FullStackEmbedded/WeatherShield/03_ExternalDocumentation/datasheet/rj11.jpeg

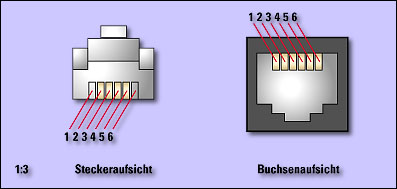
03_ExternalDocumentation/datasheet/rj11.jpeg
