FullStackEmbedded/WeatherShield/(threads)

Thread 5 (2015-12-03):

Update database

erget, 2015-12-03:
transfer data regularly to the database to make it accessible to the web server

This involves reading the sensor readings in ``/dev`` and generating SQL to interact with Django's SQLite database

erget, 2015-12-09:
@NicolasCaspari - pressureless assignment ;)

erget, 2015-12-09:
1. Script that can interact with Django layer for saving observations in database
1. Have script read sensor observations (located in ``/dev``) and save them in ``Observation`` objects that go into the DB
1. Cronjob that keeps this happening every hour (or other test period that you choose)
