FullStackEmbedded/WeatherShield/01_EagleDocuments/Base_Shield/WeatherShield_Base.brd

## EAGLE design 01_EagleDocuments/Base_Shield/WeatherShield_Base.brd (2015-11-12)

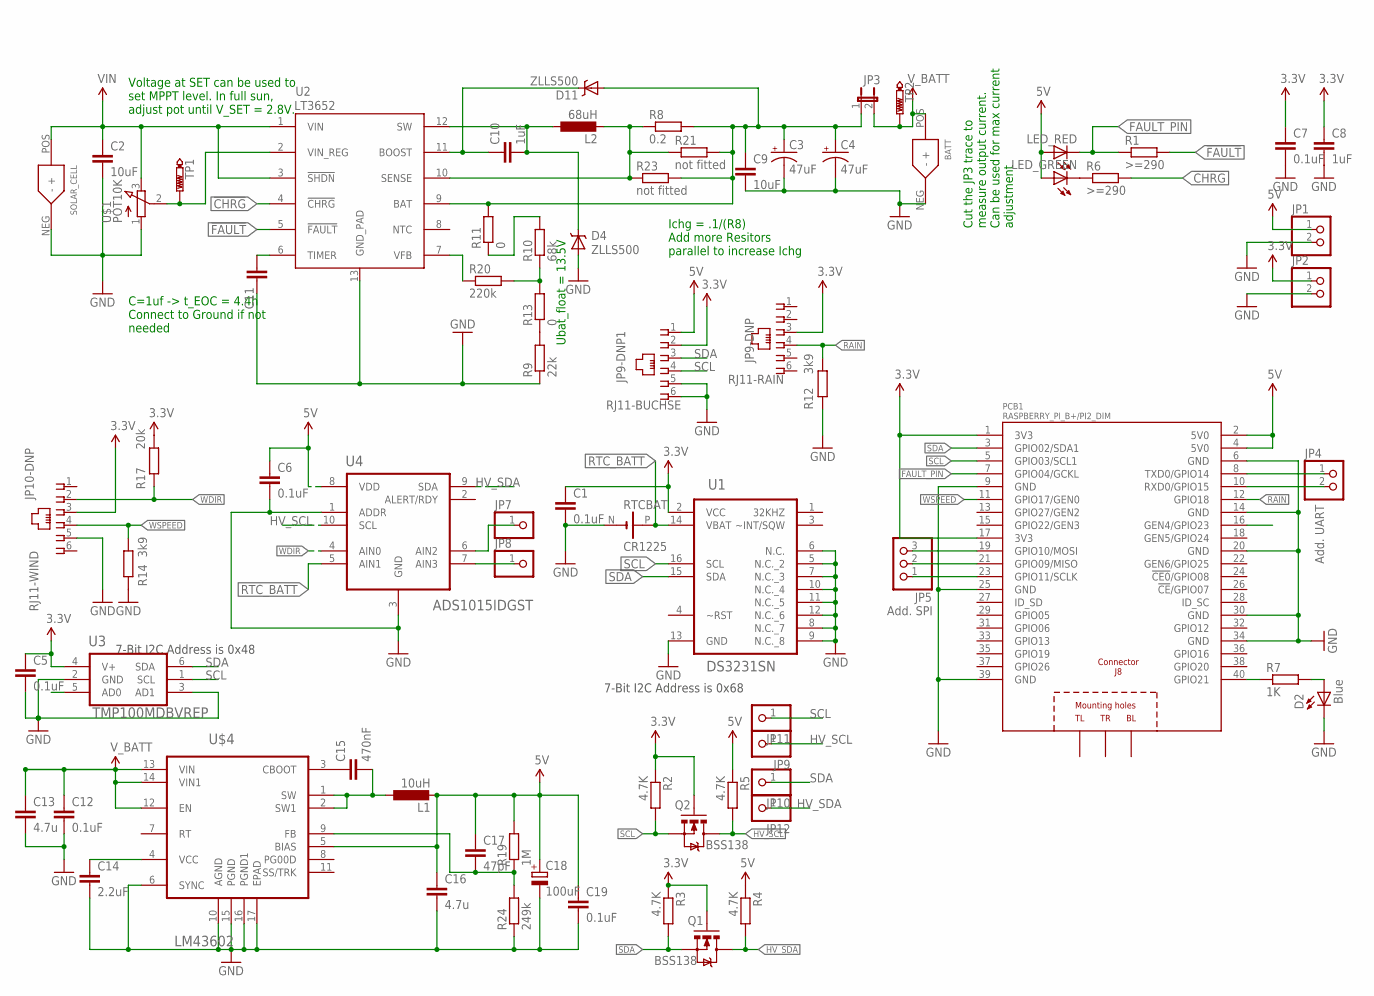
[picture p2: schematic WeatherShield_Base.sch]

Parts:
BATT: XT-60
C1, C5, C6, C7: 0.1uF; C0603
C2, C9: 10uF; C0603
C3, C4: 47uF; EIA7343-20
C8, C10: 1uF; C0603
C11: 1.0uF; C0603
C12, C19: 0.1uF; C1206
C13: 4.7u; C1206
C14: 2.2uF; C0603
C15: 470nF; C0603
C16: 4.7u; C0603
C17: 47pF; C0603
C18: 100uF; E2,5-6E
D2: Blue; LED-0603
D4, D11: ZLLS500; SOT23
JP1, JP2, JP4: PINHD-1X2; 1X02
JP3: JUMPER-PTH-2-NC; PTH-JUMPER-NC_BOTTOM_NO_SILK
JP5: PINHD-1X3; 1X03
JP7, JP8, JP9, JP10, JP11, JP12: PINHD-1X1; 1X01
JP9-DNP: RJ11-RAIN; RJ11-STECKER
JP9-DNP1: RJ11-BUCHSE; RJ11-STECKER
JP10-DNP: RJ11-WIND; RJ11-STECKER
L1: 10uH; 6000-XXXX-RC
L2: 68uH; 6000-XXXX-RC
LED_GREEN: LEDSML0603; SML0603
LED_RED: LEDSML0603; SML0603
PCB1: RASPBERRY_PI_B+/PI2_DIM; RASPBERRY_PI_BPLUS_DIM
Q1, Q2: BSS138; SOT23-3
R1, R6: >=290; R0603
R2, R3, R4, R5: 4.7K; R0603
R7: 1K; R0603
R8: 0.2; R0805
R9: 22k; R0603
R10: 68k; R0603
R11, R13: 0; R0603
R12, R14: 3k9; R0603
R17: 20k; R0603
R19: 1M; R0805
R20: 220k; R0603
R21, R23: not fitted; R0805
R24: 249k; R0805
RTCBAT: CR1225; BATTERIE_HALTER_CR1225
SOLAR_CELL: XT-60
TP1, TP2: SET; B1,27
U1: DS3231SN; SOIC127P1032X265-16N
U2: LT3652; MSOP-12_GND
U3: TMP100MDBVREP; SOT95P280X145-6N
U4: ADS1015IDGST; SOP50P490X110-10N
U$1: POT10K; POT_TS63Y_10K
U$4: LM43602; HTSSOP-16

Connections:
3.3V: C1.1, C5.1, C7.1, C8.1, JP2.1, JP9-DNP.3, JP9-DNP1.2, JP10-DNP.3, PCB1.1 (3V3), PCB1.17 (3V3), Q1.1 (G), Q2.1 (G), R2.1, R3.1, R17.1, U1.2 (VCC), U3.4 (V+)
5V: C6.1, C16.1, C17.1, C18.+, C19.1, JP1.1, JP9-DNP1.1, L1.2, LED_GREEN.A, LED_RED.A, PCB1.2 (5V0), PCB1.4 (5V0), R4.1, R5.1, R19.2, U4.8 (VDD), U$4.5 (BIAS)
!CHRG: R6.2, U2.4 (!CHRG)
!FAULT: R1.2, U2.5 (!FAULT)
BOOST: C10.1, D11.3 (C), U2.11 (BOOST)
FAULT_PIN: LED_RED.C, PCB1.7 (GPIO04/GCKL), R1.1
FB: R10.1, R13.2, R20.2
GND: BATT.NEG (-), C1.2, C2.2, C3.C (-), C4.C (-), C5.2, C6.2, C7.2, C8.2, C9.2, C11.1, C12.2, C13.2, C14.2, C16.2, C18.-, C19.2, D2.C, D4.1 (A), JP1.2, JP2.2, JP9-DNP1.5, JP9-DNP1.6, JP10-DNP.5, PCB1.6 (GND), PCB1.9 (GND), PCB1.14 (GND), PCB1.20 (GND), PCB1.25 (GND), PCB1.30 (GND), PCB1.34 (GND), PCB1.39 (GND), R9.1, R12.2, R14.2, R24.1, RTCBAT.N (-), SOLAR_CELL.NEG (-), U1.5 (N.C._2), U1.6 (N.C.), U1.7 (N.C._3), U1.8 (N.C._7), U1.9 (N.C._8), U1.10 (N.C._4), U1.11 (N.C._5), U1.12 (N.C._6), U1.13 (GND), U2.13 (GND_PAD), U3.2 (GND), U3.3 (AD1), U4.1 (ADDR), U4.3 (GND), U$1.1 (A), U$4.6 (SYNC), U$4.10 (AGND), U$4.15 (PGND), U$4.16 (PGND1), U$4.17 (EPAD)
HV_SCL: JP9.1, Q2.3 (D), R5.2, U4.10 (SCL)
HV_SDA: JP12.1, Q1.3 (D), R4.2, U4.9 (SDA)
unnamed: R9.2, R13.1
unnamed: R10.2, R11.1
unnamed: LED_GREEN.C, R6.1
unnamed: JP7.1, U4.6 (AIN2)
unnamed: JP8.1, U4.7 (AIN3)
unnamed: D2.A, R7.2
unnamed: R20.1, U2.7 (VFB)
unnamed: C3.A (+), C4.A (+), C9.1, D11.1 (A), JP3.1, R8.2, R11.2, R21.2, R23.2, U2.9 (BAT)
unnamed: C15.1, U$4.3 (CBOOT)
unnamed: JP4.1, PCB1.8 (TXD0/GPIO14)
unnamed: JP4.2, PCB1.10 (RXD0/GPIO15)
unnamed: JP5.3, PCB1.19 (GPIO10/MOSI)
unnamed: JP5.2, PCB1.21 (GPIO09/MISO)
unnamed: C17.2, R19.1, R24.2, U$4.9 (FB)
unnamed: C14.1, U$4.4 (VCC)
unnamed: C15.2, L1.1, U$4.1 (SW), U$4.2 (SW1)
unnamed: JP5.1, PCB1.23 (GPIO11/SCLK)
RAIN: JP9-DNP.4, PCB1.12 (GPIO18), R12.1
RTC_BATT: RTCBAT.P (+), U1.14 (VBAT), U4.5 (AIN1)
SCL: JP9-DNP1.4, JP11.1, PCB1.5 (GPIO03/SCL1), Q2.2 (S), R2.2, U1.16 (SCL), U3.1 (SCL)
SDA: JP9-DNP1.3, JP10.1, PCB1.3 (GPIO02/SDA1), Q1.2 (S), R3.2, U1.15 (SDA), U3.6 (SDA)
SENSE: L2.2, R8.1, R21.1, R23.1, U2.10 (SENSE)
SET: TP1.TP, U2.2 (VIN_REG), U$1.2 (S)
STAT3: PCB1.40 (GPIO21), R7.1
SW: C10.2, D4.3 (C), L2.1, U2.12 (SW)
TIMER: C11.2, U2.6 (TIMER)
VIN: C2.1, SOLAR_CELL.POS (+), U2.1 (VIN), U2.3 (!SHDN), U$1.3 (E)
V_BATT: BATT.POS (+), C12.1, C13.1, JP3.2, TP2.TP, U$4.12 (EN), U$4.13 (VIN), U$4.14 (VIN1)
WDIR: JP10-DNP.2, R17.2, U4.4 (AIN0)
WSPEED: JP10-DNP.4, PCB1.11 (GPIO17/GEN0), R14.1

Notes on the sheet:
Cut the JP3 trace to measure output current. Can be used for max current adjustment
Ichg = .1/(R8) Add more Resitors parallel to increase Ichg
Voltage at SET can be used to set MPPT level. In full sun, adjust pot until V_SET = 2.8V.
C=1uf -> t_EOC = 4.4h Connect to Ground if not needed
Add. UART
Add. SPI
7-Bit I2C Address is 0x68
7-Bit I2C Address is 0x48
Ubat_float = 13.5V

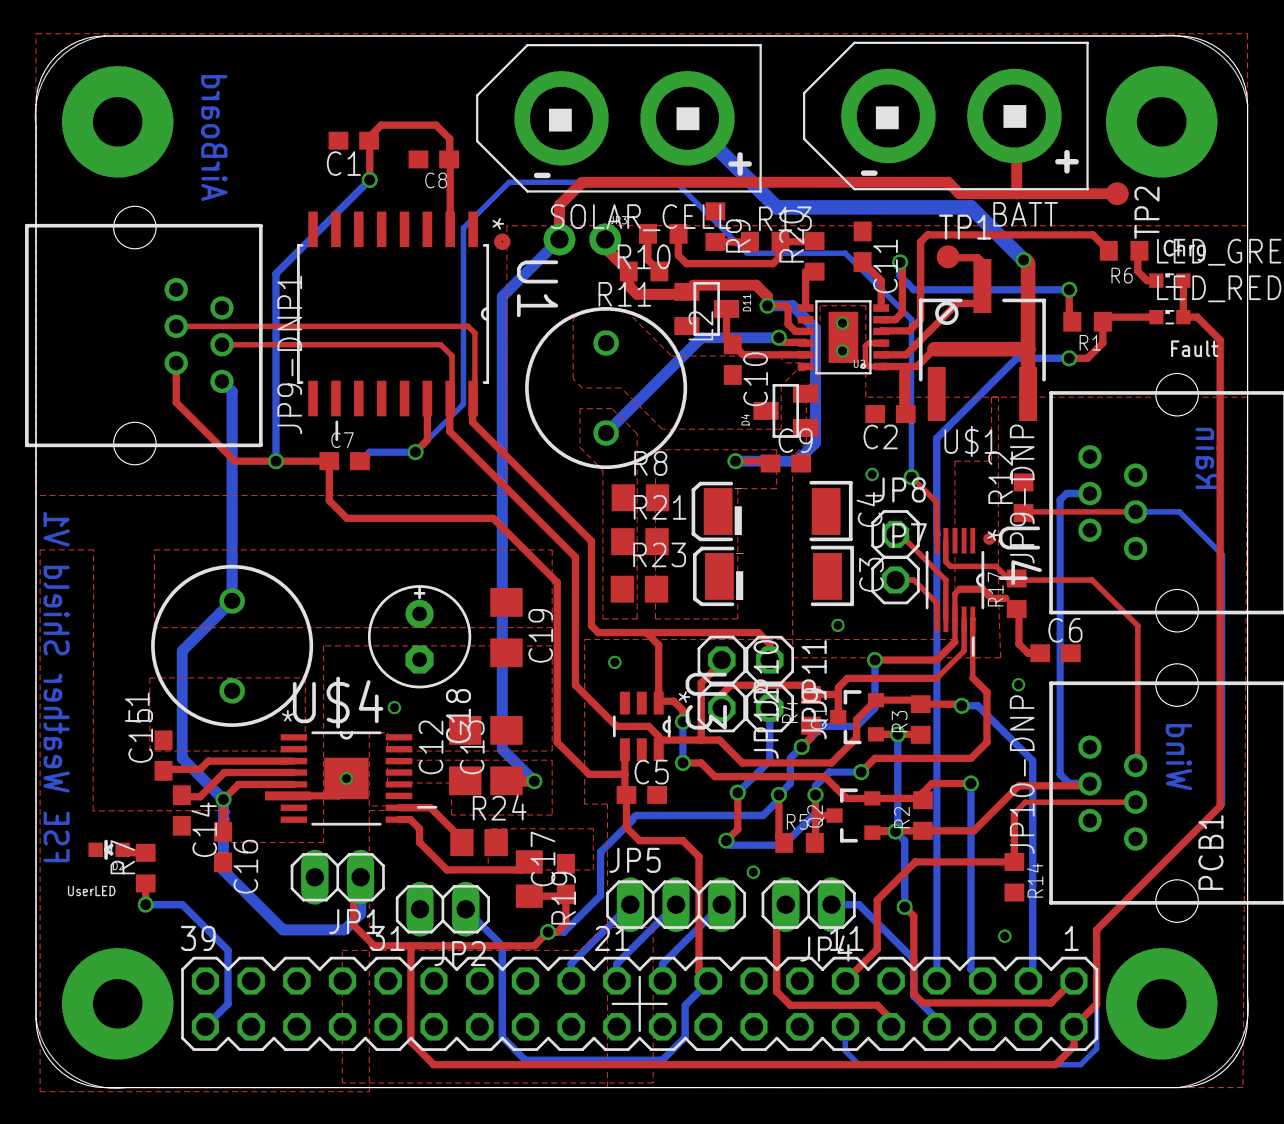
[picture p3: board WeatherShield_Base.brd from above]

Board: 2 copper layers, 67.3 x 58.4 mm, 74 parts (1 on the bottom side), 40 nets.
