FullStackEmbedded/WeatherShield/01_EagleDocuments/AirBoard_Shield/WeatherShield_Air.brd

## EAGLE design 01_EagleDocuments/AirBoard_Shield/WeatherShield_Air.brd (2015-09-22)

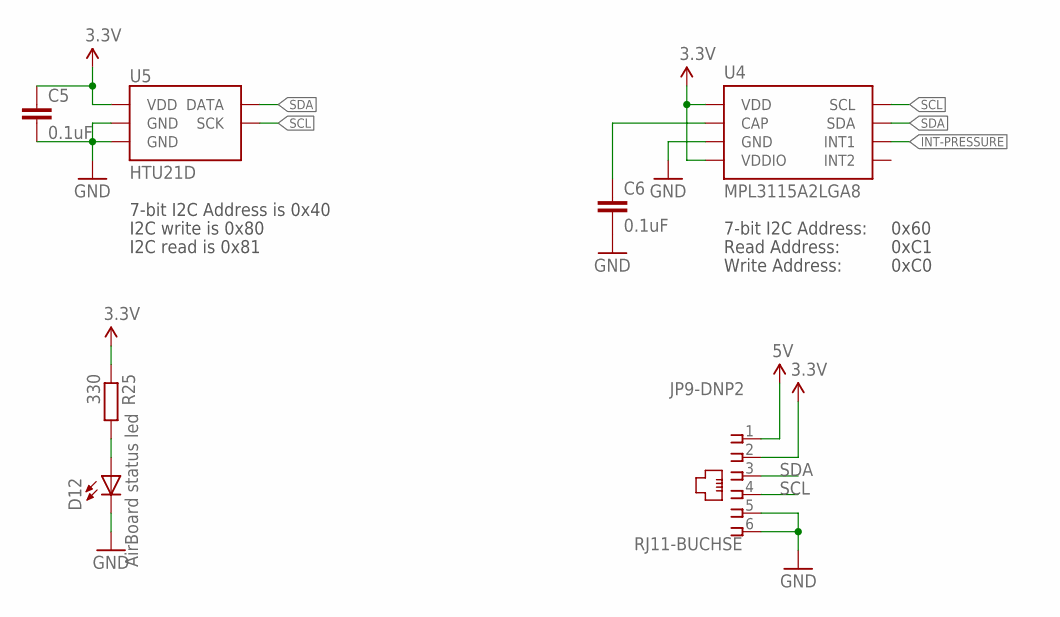
[picture p4: schematic WeatherShield_Air.sch]

Parts:
C5, C6: 0.1uF; C0603
D12: AirBoard status led; LED-0603
JP9-DNP2: RJ11-BUCHSE; RJ11-STECKER
R25: 330; R0603
U4: MPL3115A2LGA8; LGA8
U5: HTU21D

Connections:
3.3V: C5.1, JP9-DNP2.2, R25.1, U4.1 (VDD), U4.4 (VDDIO), U5.VDD
5V: JP9-DNP2.1
GND: C5.2, C6.2, D12.C, JP9-DNP2.5, JP9-DNP2.6, U4.3 (GND), U5.7 (GND), U5.GND
INT-PRESSURE: U4.6 (INT1)
unnamed: C6.1, U4.2 (CAP)
unnamed: D12.A, R25.2
SCL: JP9-DNP2.4, U4.8 (SCL), U5.SCK
SDA: JP9-DNP2.3, U4.7 (SDA), U5.DATA

Notes on the sheet:
Read Address:
Write Address:
7-bit I2C Address:
0x60
0xC1
0xC0
7-bit I2C Address is 0x40
I2C write is 0x80
I2C read is 0x81

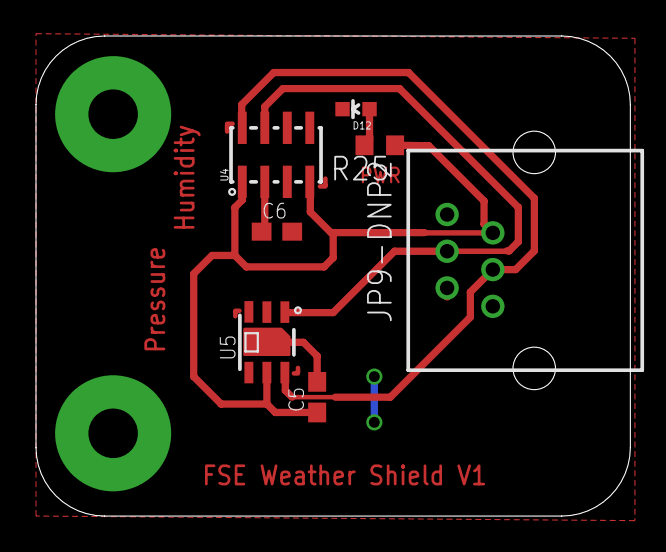
[picture p5: board WeatherShield_Air.brd from above]

Board: 2 copper layers, 33.0 x 26.7 mm, 7 parts (0 on the bottom side), 6 nets.
