FullStackEmbedded/WeatherShield/WeatherShield.brd

## EAGLE design WeatherShield.brd (2015-07-26)

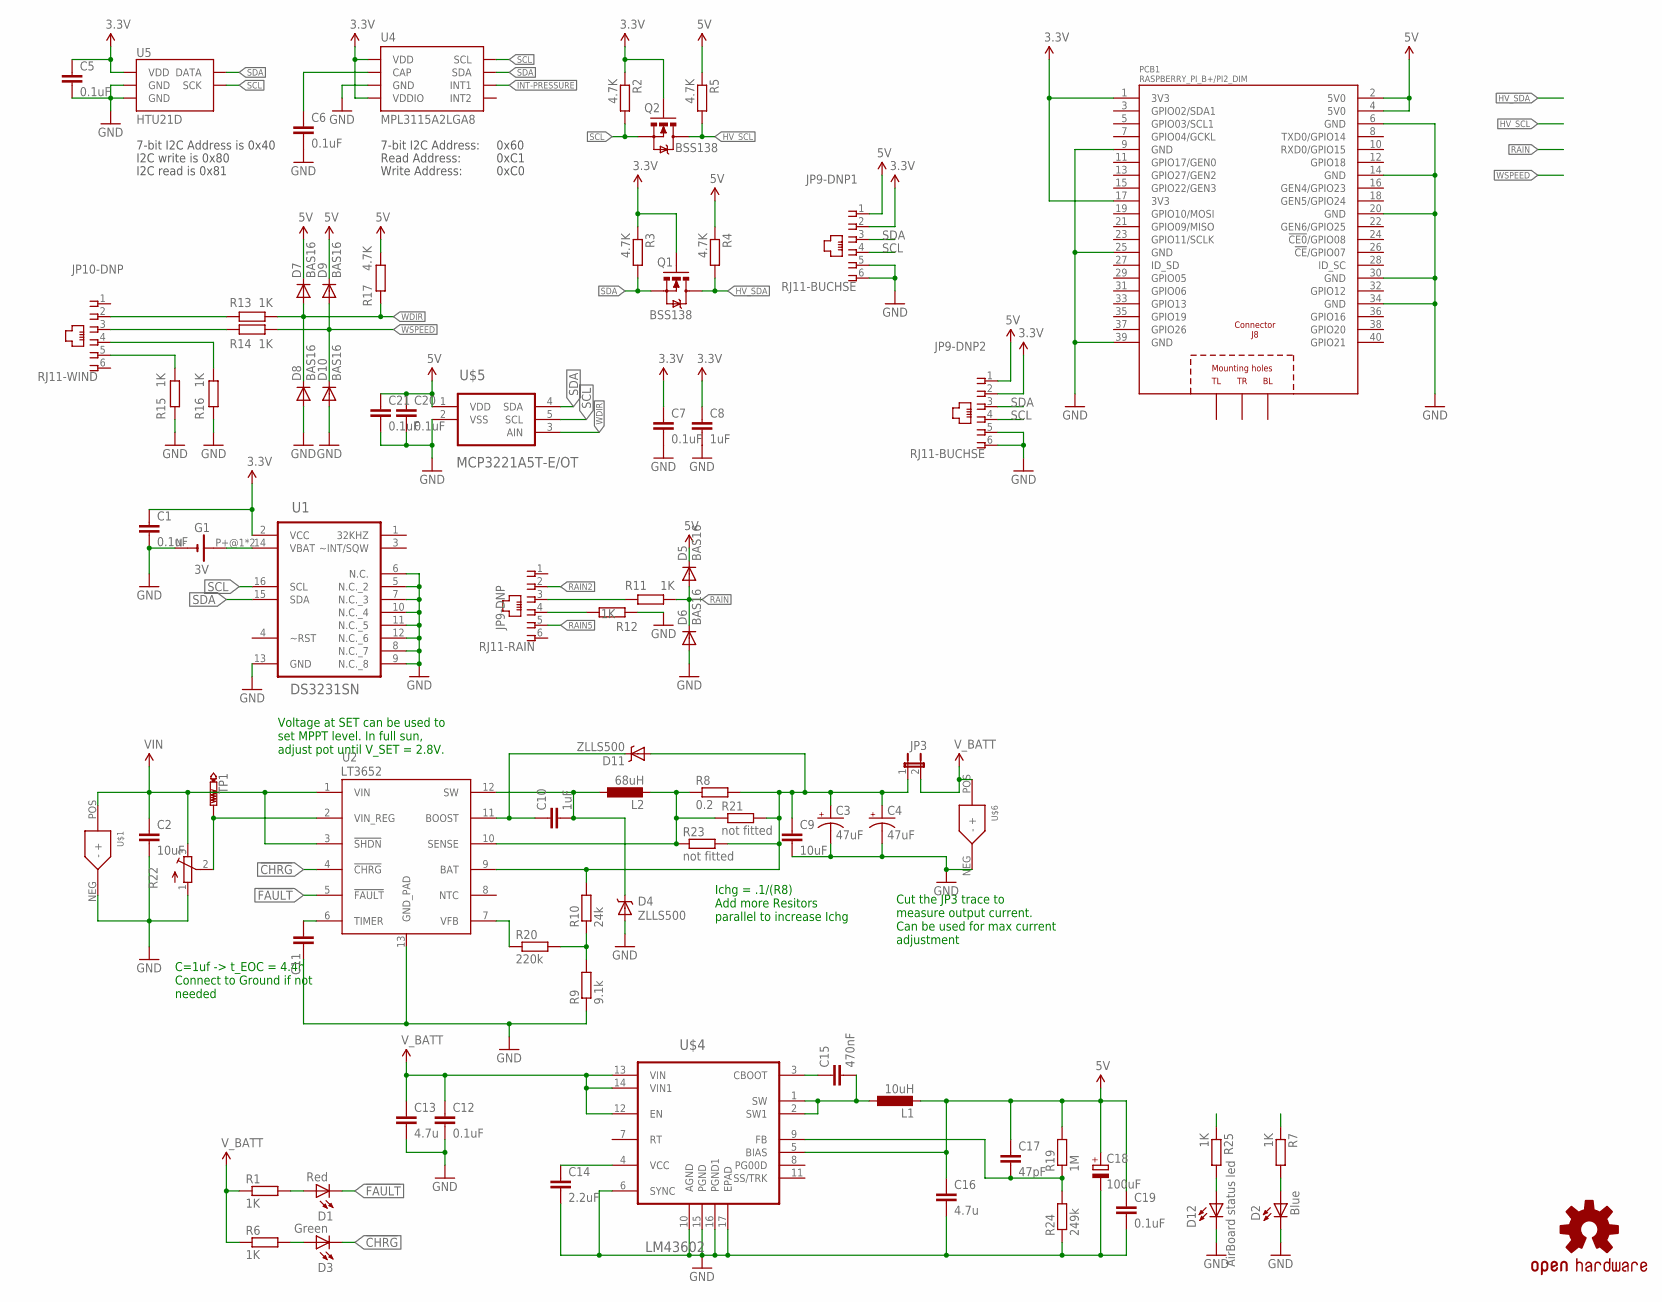
[picture p6: schematic WeatherShield.sch]

Parts:
C1, C5, C6, C7, C20, C21: 0.1uF; C0603
C2, C9: 10uF; C0603
C3, C4: 47uF; EIA7343-20
C8, C10: 1uF; C0603
C11: 1.0uF; C0603
C12, C19: 0.1uF; C1206
C13: 4.7u; C1206
C14: 2.2uF; C0603
C15: 470nF; C0603
C16: 4.7u; C0603
C17: 47pF; C0603
C18: 100uF; E2,5-6E
D1: Red; LED-0603
D2: Blue; LED-0603
D3: Green; LED-0603
D4, D11: ZLLS500; SOT23
D5, D6, D7, D8, D9, D10: BAS16; SOD-323
D12: AirBoard status led; LED-0603
G1: 3V; CELL_RETAINER_11.6MM
JP3: JUMPER-PTH-2-NC; PTH-JUMPER-NC_BOTTOM_NO_SILK
JP9-DNP: RJ11-RAIN; RJ11-STECKER
JP9-DNP1, JP9-DNP2: RJ11-BUCHSE; RJ11-STECKER
JP10-DNP: RJ11-WIND; RJ11-STECKER
L1: 10uH; 6000-XXXX-RC
L2: 68uH; 6000-XXXX-RC
LOGO1: OSHW-LOGOM; OSHW-LOGO-M
PCB1: RASPBERRY_PI_B+/PI2_DIM; RASPBERRY_PI_BPLUS_DIM
Q1, Q2: BSS138; SOT23-3
R1, R6, R7, R11, R12, R13, R14, R15, R16, R25: 1K; R0603
R2, R3, R4, R5, R17: 4.7K; R0603
R8: 0.2; R0805
R9: 9.1k; R0603
R10: 24k; R0603
R19: 1M; R0805
R20: 220k; R0603
R21, R23: not fitted; R0805
R22: TRIM_EU-SM-42/43A; SM-42/43A
R24: 249k; R0805
TP1: SET; B1,27
U1: DS3231SN; SOIC127P1032X265-16N
U2: LT3652; MSOP-12_GND
U4: MPL3115A2LGA8; LGA8
U5: HTU21D
U$1, U$6: XT-60
U$4: LM43602; HTSSOP-16
U$5: MCP3221A5T-E/OT; SOT95P270X145-5N

Connections:
3.3V: C1.1, C5.1, C7.1, C8.1, JP9-DNP1.2, JP9-DNP2.2, PCB1.1 (3V3), PCB1.17 (3V3), Q1.1 (G), Q2.1 (G), R2.1, R3.1, U1.2 (VCC), U4.1 (VDD), U4.4 (VDDIO), U5.VDD
5V: C16.1, C17.1, C18.+, C19.1, C20.1, C21.1, D5.1 (C), D7.1 (C), D9.1 (C), JP9-DNP1.1, JP9-DNP2.1, L1.2, PCB1.2 (5V0), PCB1.4 (5V0), R4.1, R5.1, R17.1, R19.2, U$4.5 (BIAS), U$5.1 (VDD)
!CHRG: D3.C, U2.4 (!CHRG)
!FAULT: D1.C, U2.5 (!FAULT)
BOOST: C10.1, D11.3 (C), U2.11 (BOOST)
FB: R9.2, R10.1, R20.2
GND: C1.2, C2.2, C3.C (-), C4.C (-), C5.2, C6.2, C7.2, C8.2, C9.2, C11.1, C12.2, C13.2, C14.2, C16.2, C18.-, C19.2, C20.2, C21.2, D2.C, D4.1 (A), D6.2 (A), D8.2 (A), D10.2 (A), D12.C, G1.N- (-), JP9-DNP1.5, JP9-DNP1.6, JP9-DNP2.5, JP9-DNP2.6, PCB1.6 (GND), PCB1.9 (GND), PCB1.14 (GND), PCB1.20 (GND), PCB1.25 (GND), PCB1.30 (GND), PCB1.34 (GND), PCB1.39 (GND), R9.1, R12.2, R15.2, R16.2, R22.1 (A), R24.1, U1.5 (N.C._2), U1.6 (N.C.), U1.7 (N.C._3), U1.8 (N.C._7), U1.9 (N.C._8), U1.10 (N.C._4), U1.11 (N.C._5), U1.12 (N.C._6), U1.13 (GND), U2.13 (GND_PAD), U4.3 (GND), U5.7 (GND), U5.GND, U$1.NEG (-), U$4.6 (SYNC), U$4.10 (AGND), U$4.15 (PGND), U$4.16 (PGND1), U$4.17 (EPAD), U$5.2 (VSS), U$6.NEG (-)
HV_SCL: Q2.3 (D), R5.2
HV_SDA: Q1.3 (D), R4.2
INT-PRESSURE: U4.6 (INT1)
unnamed: JP10-DNP.3, R14.2
unnamed: JP10-DNP.2, R13.2
unnamed: D1.A, R1.2
unnamed: JP9-DNP.3, R11.2
unnamed: C6.1, U4.2 (CAP)
unnamed: G1.P+@1 (+), G1.P+@2 (+), U1.14 (VBAT)
unnamed: D3.A, R6.2
unnamed: D2.A, R7.2
unnamed: JP9-DNP.4, R12.1
unnamed: JP10-DNP.5, R15.1
unnamed: JP10-DNP.4, R16.1
unnamed: R20.1, U2.7 (VFB)
unnamed: C3.A (+), C4.A (+), C9.1, D11.1 (A), JP3.1, R8.2, R10.2, R21.2, R23.2, U2.9 (BAT)
unnamed: C15.1, U$4.3 (CBOOT)
unnamed: C17.2, R19.1, R24.2, U$4.9 (FB)
unnamed: C14.1, U$4.4 (VCC)
unnamed: C15.2, L1.1, U$4.1 (SW), U$4.2 (SW1)
unnamed: D12.A, R25.2
RAIN: D5.2 (A), D6.1 (C), R11.1
RAIN2: JP9-DNP.2
RAIN5: JP9-DNP.5
SCL: JP9-DNP1.4, JP9-DNP2.4, Q2.2 (S), R2.2, U1.16 (SCL), U4.8 (SCL), U5.SCK, U$5.5 (SCL)
SDA: JP9-DNP1.3, JP9-DNP2.3, Q1.2 (S), R3.2, U1.15 (SDA), U4.7 (SDA), U5.DATA, U$5.4 (SDA)
SENSE: L2.2, R8.1, R21.1, R23.1, U2.10 (SENSE)
SET: R22.2 (S), TP1.TP, U2.2 (VIN_REG)
STAT1: R25.1
STAT3: R7.1
SW: C10.2, D4.3 (C), L2.1, U2.12 (SW)
TIMER: C11.2, U2.6 (TIMER)
VIN: C2.1, R22.3 (E), U2.1 (VIN), U2.3 (!SHDN), U$1.POS (+)
V_BATT: C12.1, C13.1, JP3.2, R1.1, R6.1, U$4.12 (EN), U$4.13 (VIN), U$4.14 (VIN1), U$6.POS (+)
WDIR: D7.2 (A), D8.1 (C), R13.1, R17.2, U$5.3 (AIN)
WSPEED: D9.2 (A), D10.1 (C), R14.1

Notes on the sheet:
Read Address:
Write Address:
7-bit I2C Address:
0x60
0xC1
0xC0
7-bit I2C Address is 0x40
I2C write is 0x80
I2C read is 0x81
Cut the JP3 trace to measure output current. Can be used for max current adjustment
Ichg = .1/(R8) Add more Resitors parallel to increase Ichg
Voltage at SET can be used to set MPPT level. In full sun, adjust pot until V_SET = 2.8V.
C=1uf -> t_EOC = 4.4h Connect to Ground if not needed

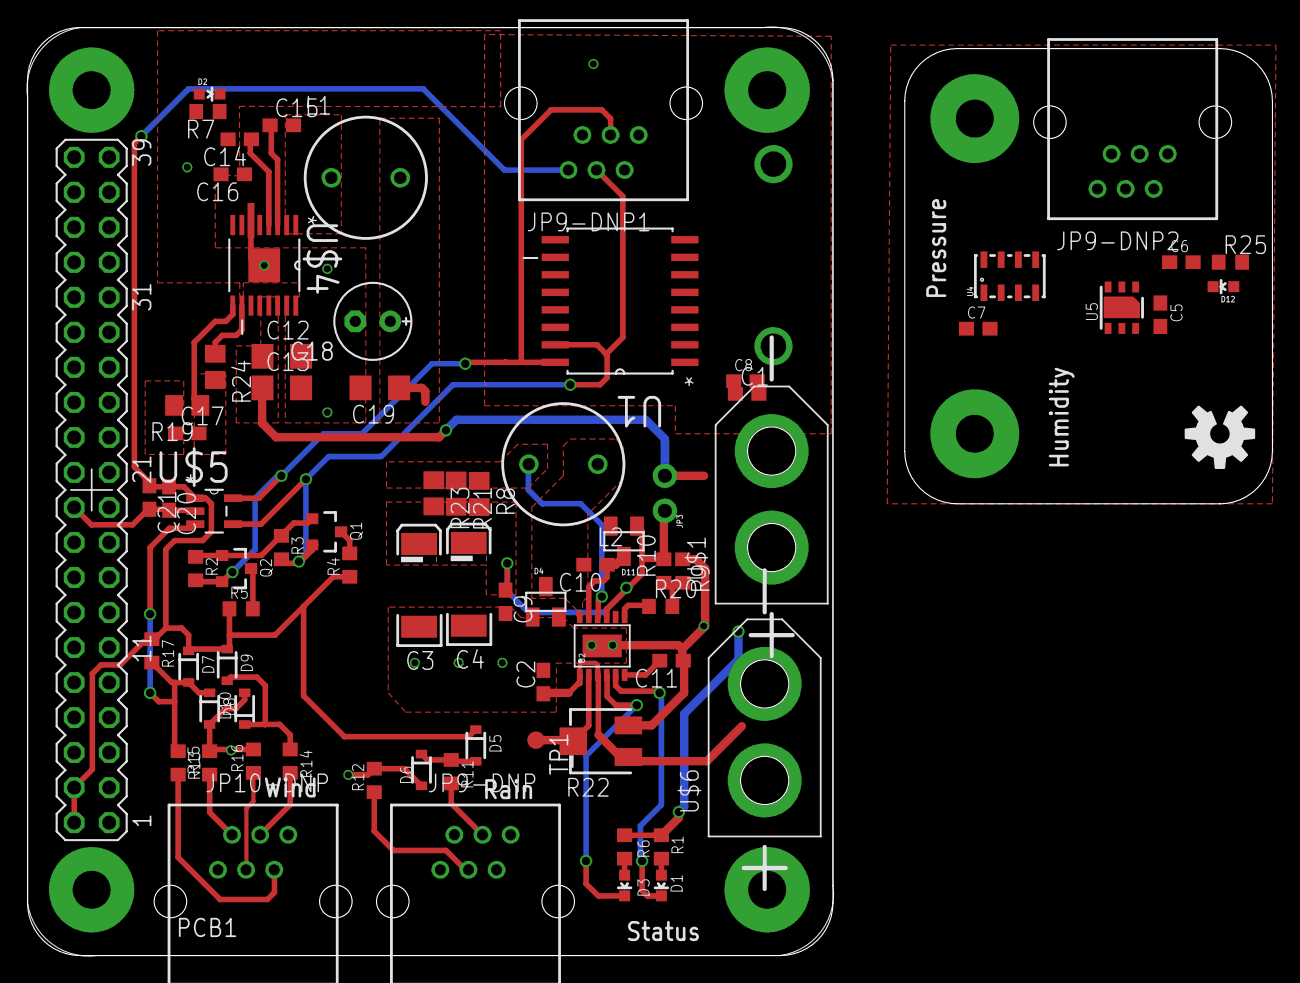
[picture p7: board WeatherShield.brd from above]

Board: 2 copper layers, 58.4 x 67.3 mm, 78 parts (1 on the bottom side), 38 nets.
