FullStackEmbedded/WeatherShield/(commit log)

2015-07-08 FSE_Weather_Shield.lbr added
    [Weather Shield.brd, Weather Shield.sch]
2015-07-15 initial project version
    [Weather Shield.brd, Weather Shield.sch]
2015-07-20 Files rename
    [WeatherShield.brd, WeatherShield.sch]
2015-07-20 Power parts
    [WeatherShield.brd, WeatherShield.sch]
2015-07-23 5V supply done
    [WeatherShield.brd, WeatherShield.sch]
2015-07-23 EagleCleanup.py added
    [WeatherShield.brd, WeatherShield.sch]
2015-07-27 WeatherShield v1
    Restructuration des Fichiers
    Division en Air et Base Board
    [WeatherShield_Air.brd, WeatherShield_Air.sch, WeatherShield_Base.brd, WeatherShield_Base.sch]
2015-07-27 WeatherShield v1
    First attempt almost done
    GPIO routing is missing
    [WeatherShield_Base.brd]
2015-07-27 WeatherShield v1
    [WeatherShield_Air.brd, WeatherShield_Air.sch]
2015-07-31 WeatherShield_v1
    routing....
    [WeatherShield_Base.brd, WeatherShield_Base.sch]
2015-10-09 Reorganize driver classes
2015-11-12 Implement scheduler for real application
    Sensor polling is performed by separate threads dispatched in the main
    function. Polling intervals, etc. are still hardwired.
